FabianPlum/2DTreadMill/(commit log)

2022-10-05 Added basic stepper communication script, on top of which the arduino control side will be built
2022-10-07 Added Kalman Filter for tracker
2022-10-07 Added stepper test control (arduino + python)
2022-10-07 Added independent motor-speed control
2022-10-07 Added X-Y stepper PID controller
2022-10-08 Improved stepper control, added dead-band, direction switch
2022-11-23 Cleaned 2D PID loop and signal filtering
2022-11-25 Added comprehensive TODO list for design and assembly
2023-03-17 Added Oak-D demo mode when no Arduino is connected
